tzai/rf-19-can-module/Images/front_zoom.PNG

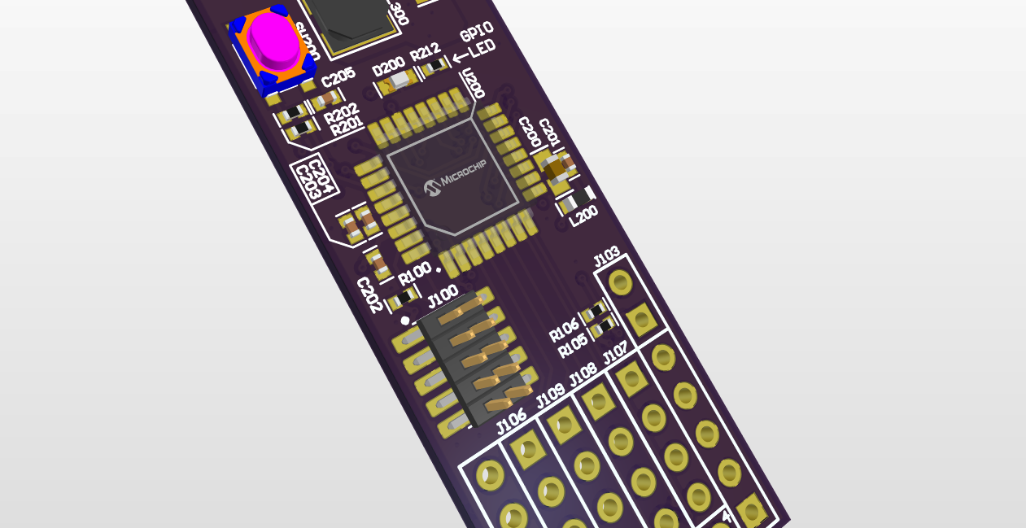
Images/front_zoom.PNG
