tzai/rf-19-can-module/RF19_Sensor_CAN_Module.pdf

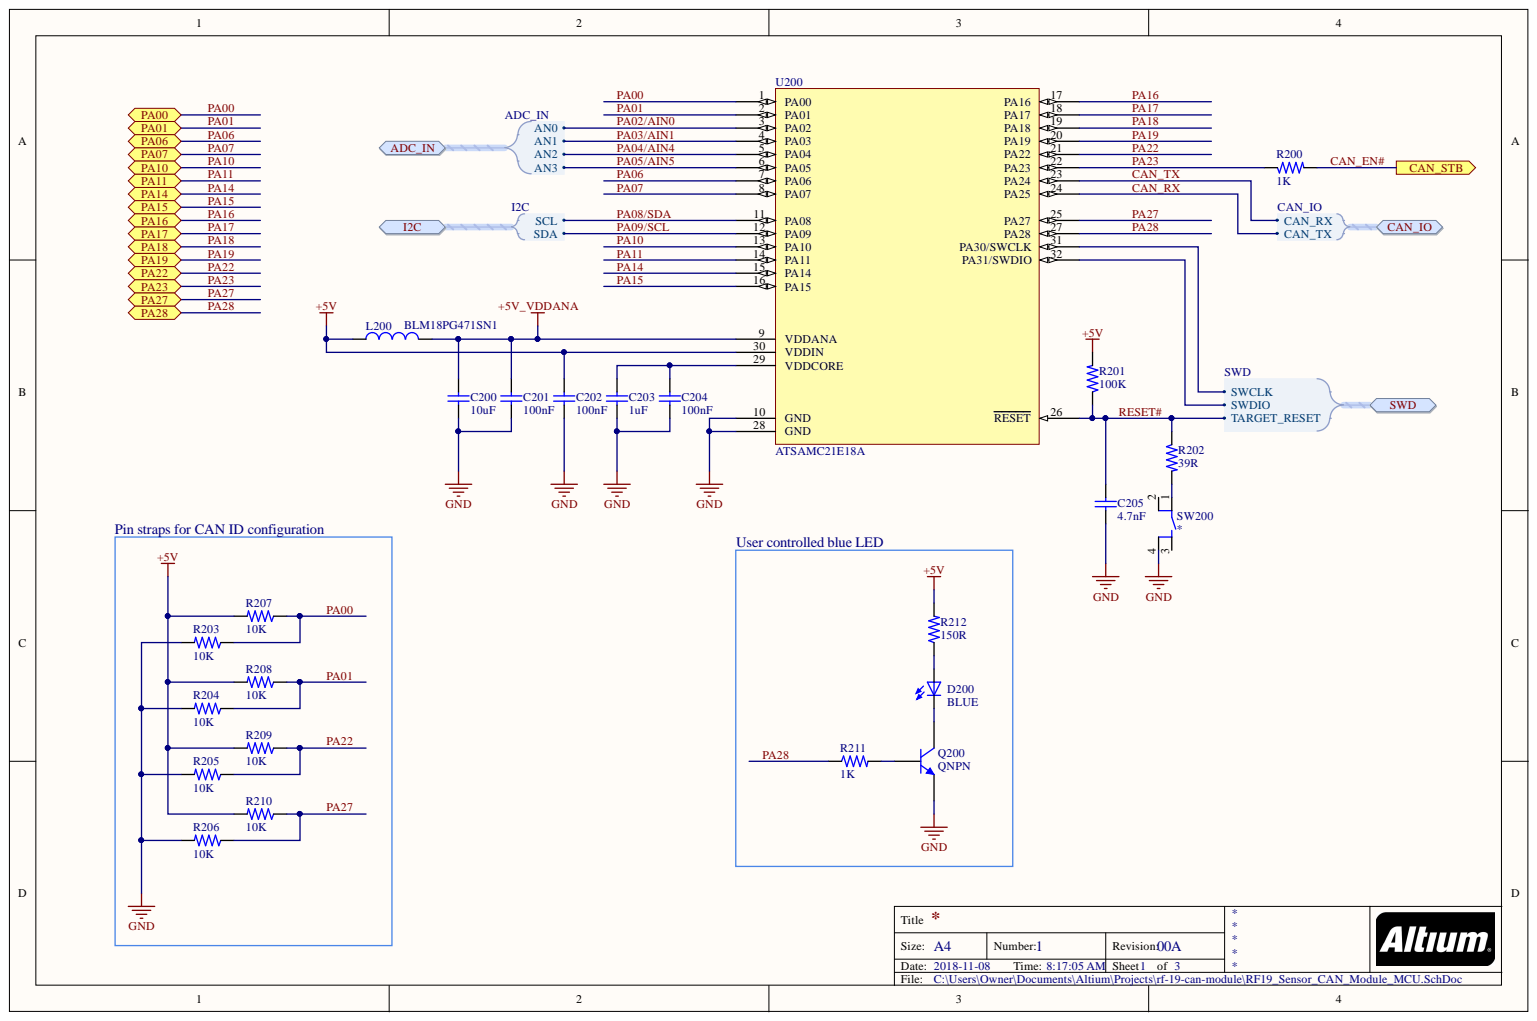
[picture p6: page 1]

2 5 | PA 2 7
2 7 | PA 2 8

ps for CAN ID c

Size: A4 | N umber: 1 | Rev i s i o n : 0 0 A
Date: 8-1 1-0 T ime: : : A M | | Sheet o f

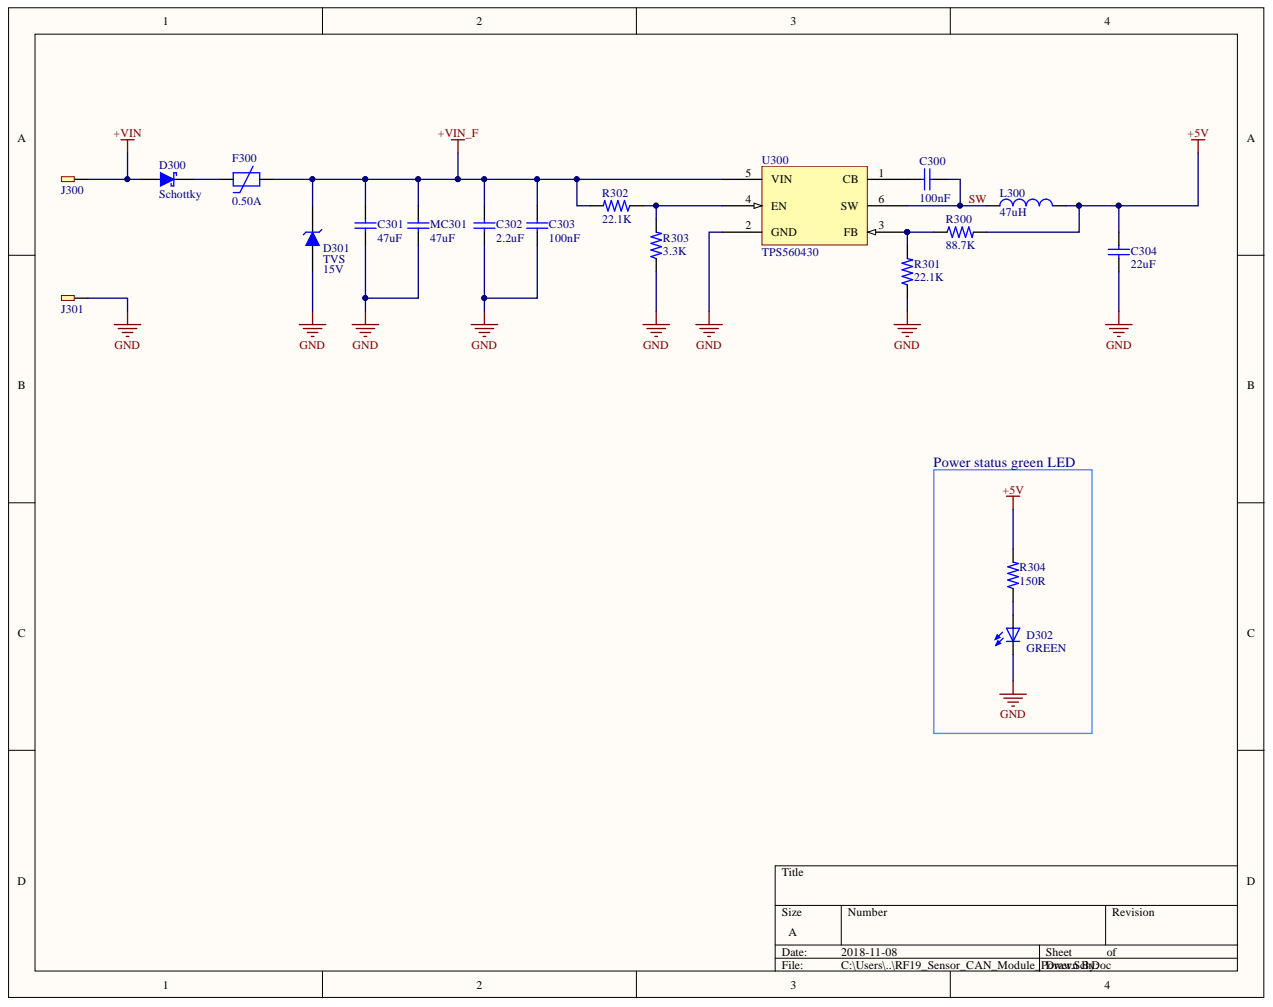
[picture p7: page 2]

Power status green LED

Size | Number | Revision

Date: 2018-11-08 | Sheet of
File: C:\Users\..\RF19_Sensor_CAN_Module_PoDrwer awn.Sch ByDo: c

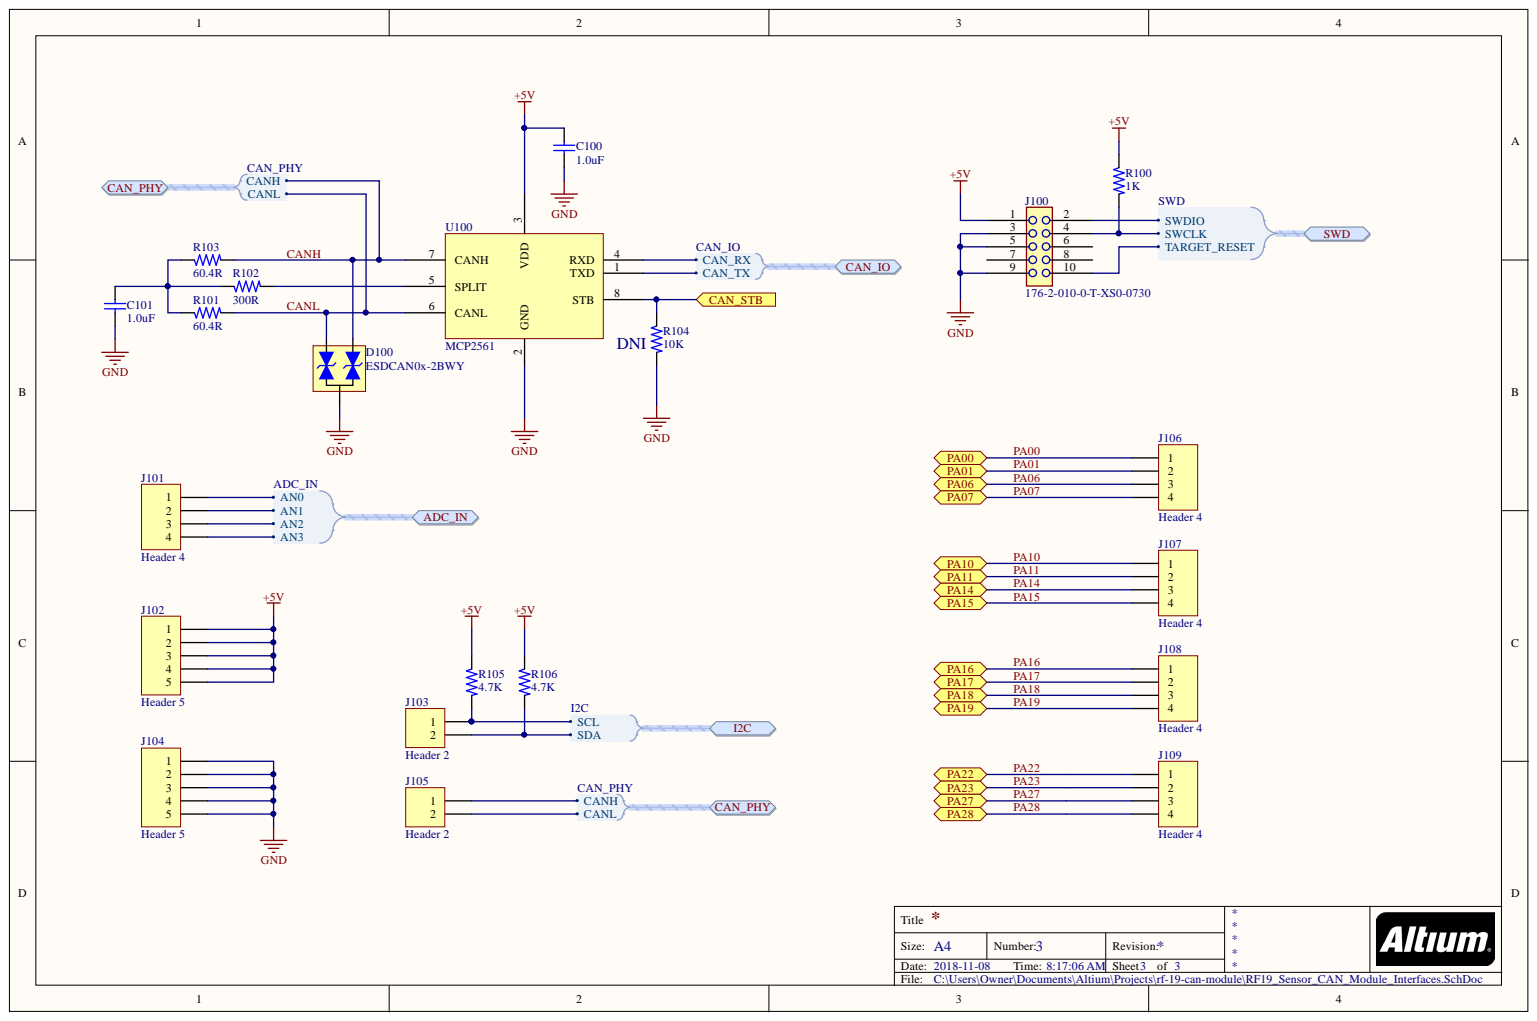
[picture p8: page 3]

9 | 1 0

Header 4 1234 J107 Header 4 1234 J108 Header 4 1234 J109 Header 4

Size: A4 | N umber: 3 | Rev i s i o n : *
Date: 8-1 1-0 T ime: : : M | | Sheet o f

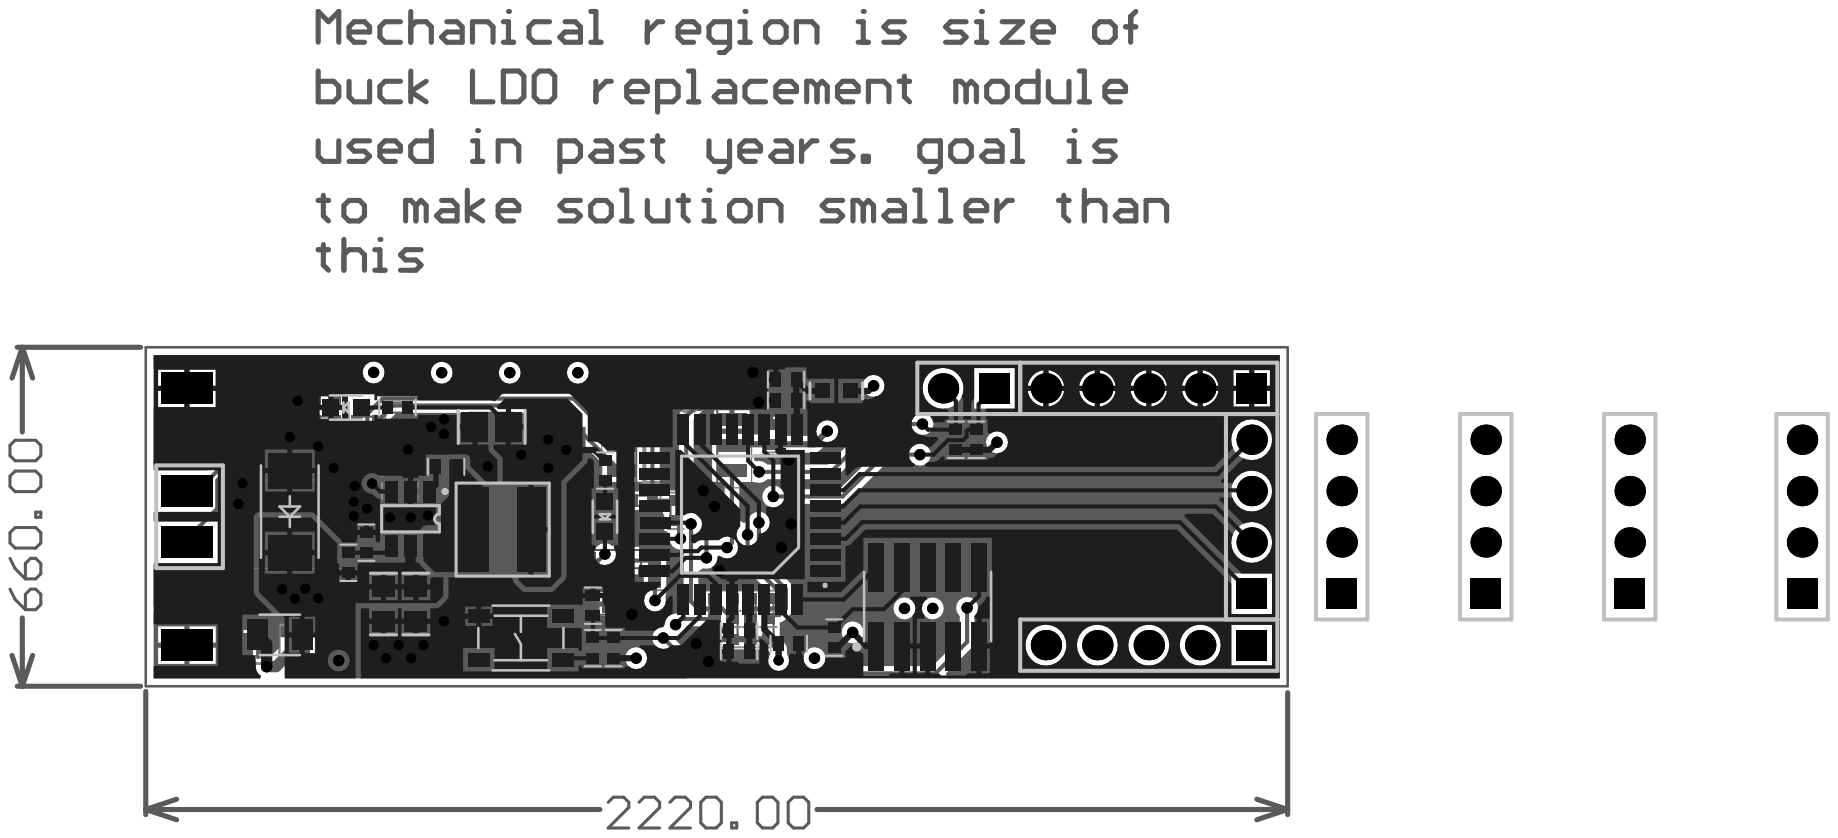
[picture p9: page 4]
