tzai/rf-19-can-module/(list of files, drawings)

Other design files:
RF19_Sensor_CAN_Module.PcbDoc
RF19_Sensor_CAN_Module.PrjPcb
RF19_Sensor_CAN_Module_Interfaces.SchDoc
RF19_Sensor_CAN_Module_MCU.SchDoc
RF19_Sensor_CAN_Module_Power.SchDoc
