tzai/rf-19-can-module/(commit log)

2018-10-12 Initial Altium commit
    [RF19_Sensor_CAN_Module.PrjPcb, RF19_Sensor_CAN_Module_Interfaces.SchDoc, RF19_Sensor_CAN_Module_MCU.SchDoc, RF19_Sensor_CAN_Module_Power.SchDoc]
2018-10-25 Updated power section, cleaned up PCB and SCH libraries so that they are locally referenced
    [RF19_Sensor_CAN_Module.PrjPcb]
2018-10-25 updated reference designators
    [RF19_Sensor_CAN_Module_MCU.SchDoc]
2018-10-26 Add PcbDoc file and remove debug.log and __Previews folder from version control
    [RF19_Sensor_CAN_Module.PcbDoc, RF19_Sensor_CAN_Module.PrjPcb, RF19_Sensor_CAN_Module_Interfaces.SchDoc, RF19_Sensor_CAN_Module_MCU.SchDoc, RF19_Sensor_CAN_Module_Power.SchDoc]
2018-10-26 Add UVLO voltage divider to lock out regulator when Vin < 9V, change polarity protection diode to smaller package size, add preliminary inductor component and value
    [RF19_Sensor_CAN_Module.PcbDoc, RF19_Sensor_CAN_Module_Power.SchDoc]
2018-10-26 Modify main project file
    [RF19_Sensor_CAN_Module.PrjPcb]
2018-10-29 Add more placement/routing and some new features
    - power status and user controlled LEDs
    - pin straps for configuring CAN IDs through the BOM (no software modification needed)
    - smaller form factor bulk capacitors
    - smaller overall board size
    - preliminary routing for CANH/CANL
    [RF19_Sensor_CAN_Module.PcbDoc, RF19_Sensor_CAN_Module.PrjPcb, RF19_Sensor_CAN_Module_Interfaces.SchDoc, RF19_Sensor_CAN_Module_MCU.SchDoc, RF19_Sensor_CAN_Module_Power.SchDoc]
2018-11-07 Add pinstrap placement and designators
    [RF19_Sensor_CAN_Module.PcbDoc, RF19_Sensor_CAN_Module_MCU.SchDoc, RF19_Sensor_CAN_Module_Power.SchDoc]
2018-11-08 Finish preliminary routing, add breakout connectors, but not yet placed
    [RF19_Sensor_CAN_Module.PcbDoc, RF19_Sensor_CAN_Module.PrjPcb, RF19_Sensor_CAN_Module_Interfaces.SchDoc, RF19_Sensor_CAN_Module_MCU.SchDoc]
2018-11-08 Add .gitignore, add partial breakout terminal placement and layout
    [RF19_Sensor_CAN_Module.PcbDoc, RF19_Sensor_CAN_Module.PrjPcb]
2018-11-13 Finalize all routing and silkscreen placement - add RFR and Altium logos - silkscreen designators placed in readable places, and labels added for all terminals - FB resistors for SMPS brought to top 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
    [RF19_Sensor_CAN_Module.PrjPcb, RF19_Sensor_CAN_Module_Interfaces.SchDoc, RF19_Sensor_CAN_Module_MCU.SchDoc, RF19_Sensor_CAN_Module_Power.SchDoc]
2018-11-13 Add draftsman file, add fabrication configuration that's compatible with OSHPark
    [RF19_Sensor_CAN_Module.PrjPcb]
2018-11-13 Add OutJobs for gerber generation, change all vias to tented, and modify stackup to use signal layers instead of internal plane layers (fix for negative gerbers)
2018-11-23 Fixed PCB stackup, changed C200 to 0603 since no 0402 was available
    [RF19_Sensor_CAN_Module_MCU.SchDoc]
2018-12-01 Add supplier links to common caps and resistors
    -common parts now have dedicated library items that represent a specific component instead of being generic. e.g. there are now separate components for 1K, 10K and 100K 5% 0402 resistors
    [RF19_Sensor_CAN_Module.PrjPcb, RF19_Sensor_CAN_Module_Interfaces.SchDoc, RF19_Sensor_CAN_Module_MCU.SchDoc, RF19_Sensor_CAN_Module_Power.SchDoc]
2018-12-18 Add more supplier links, only missing Power page now
    [RF19_Sensor_CAN_Module_Interfaces.SchDoc, RF19_Sensor_CAN_Module_Power.SchDoc]
2018-12-19 Add more supplier links for power page capacitors and precision resistors. Missing TVS, schottky and fuse supplier links
    [RF19_Sensor_CAN_Module_MCU.SchDoc, RF19_Sensor_CAN_Module_Power.SchDoc]
2018-12-21 Add all necessary supplier links on power page, except 22uF input capacitors
    [RF19_Sensor_CAN_Module.PrjPcb, RF19_Sensor_CAN_Module_Interfaces.SchDoc, RF19_Sensor_CAN_Module_Power.SchDoc]
2019-01-27 Finalize BOM supplier links, everything ready to gerber out
    [RF19_Sensor_CAN_Module_Interfaces.SchDoc, RF19_Sensor_CAN_Module_Power.SchDoc]
